makerhafen/MAAPS/hardware/README.md

## MAAPS Hardware

#### Case

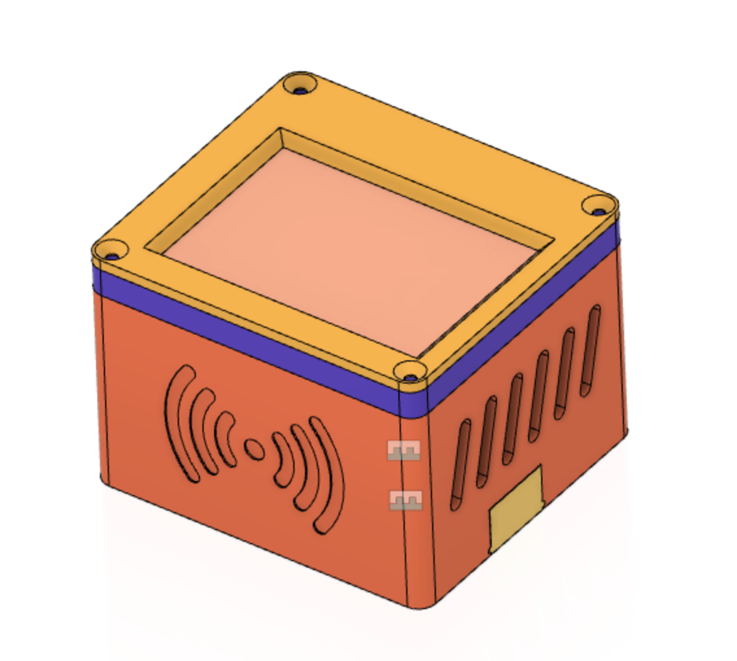
[picture p1: hardware/case.png]
