makerhafen/MAAPS/(list of files, cad)

Other CAD files:
hardware/case.f3d
