makerhafen/MAAPS/(commit log)

2026-08-13 some updates
    [devices.csv]
2026-08-19 ai updates
    [devices.csv]
